LOBSTER-Robotics/EE-Dev-BAP/DCD/DCD.kicad_sch

## KiCad design DCD/DCD.kicad_sch (2026-06-09)

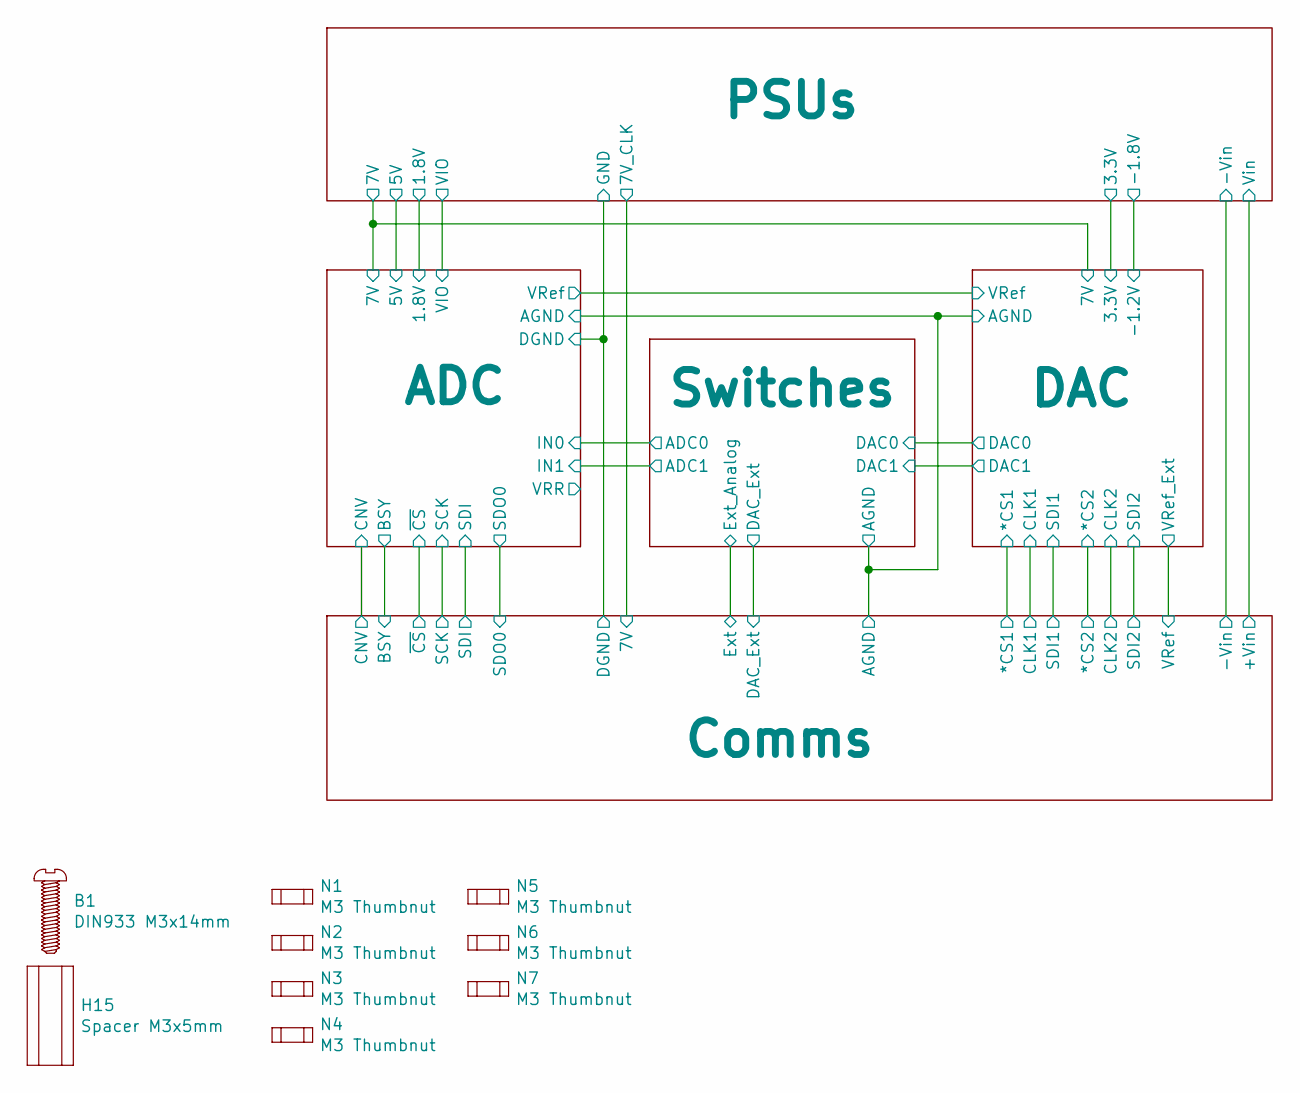
[picture p1: schematic DCD.kicad_sch]

Parts:
B1: DIN933 M3x14mm; Screw_DIN933_M3x14mm; Part number ISO7380 M5x0.8mm A2
H15: Spacer M3x5mm; ThreadedSpacer_6mm_M3x0.5_5mm; Part number M1302-3005-SS
N1, N2, N3, N4, N5, N6, N7: M3 Thumbnut; ThumbNut-M3; Part number M3561-B-12
