LOBSTER-Robotics/EE-Dev-BAP/DCD/Subcircuits/adc.kicad_sch

## KiCad design DCD/Subcircuits/adc.kicad_sch (2026-06-09)

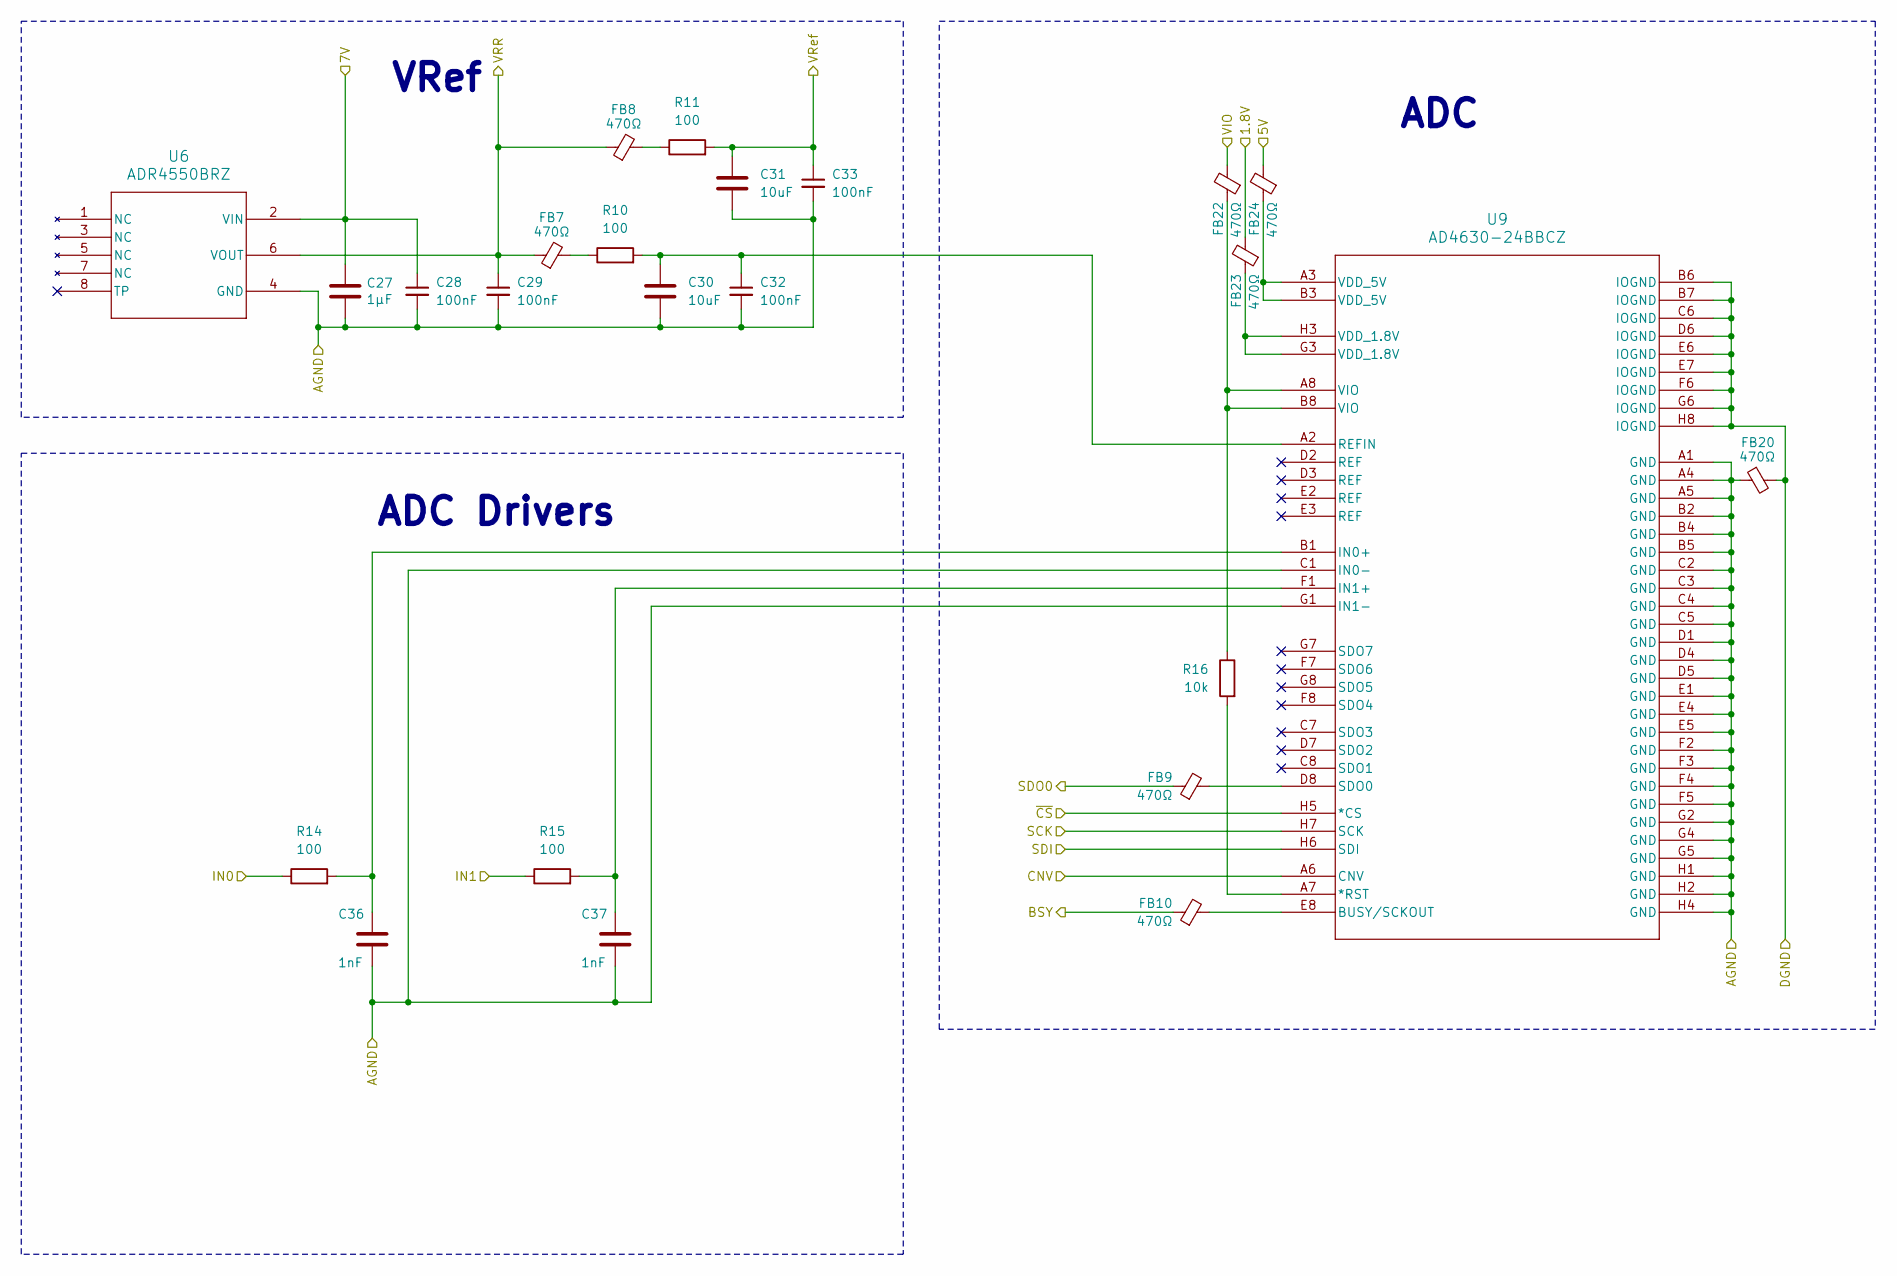
[picture p2: schematic adc.kicad_sch]

Parts:
C27: 1µF; C_0603_1608Metric; Part number GCJ188R71E105KA01D
C28, C29, C32, C33: 100nF; C_0603_1608Metric; Part number GCJ188R72A104KA1D
C30, C31: 10uF; C_1210_3225Metric; Part number GRM32EC72A106ME05L
C36, C37: 1nF; C_0603_1608Metric; Part number GCM1885C2A102FA16D
FB7, FB8, FB9, FB10, FB20, FB22, FB23, FB24: 470Ω; L_0603_1608Metric; Part number BLM18GG471SN1D
R10, R11, R15: 100; R_0603_1608Metric
R14: 100; R_0603_1608Metric; Part number ERA-3VEB1000V
R16: 10k; R_0603_1608Metric; Part number ERJ-3EKF1002V
U6: ADR4550BRZ; R_8_ADI; Part number ADR4550BRZ-R7
U9: AD4630-24BBCZ; 05-08-1797_ADI; Part number AD4630-24BBCZ

Connections:
1.8V: FB23.2
5V: FB24.2
7V: C27.1, C28.1, U6.2 (VIN)
AGND: C27.2, C28.2, C29.2, C30.2, C31.2, C32.2, C33.2, C36.2, C37.2, FB20.1, U6.4 (GND), U9.A1 (GND), U9.A4 (GND), U9.A5 (GND), U9.B2 (GND), U9.B4 (GND), U9.B5 (GND), U9.C1 (IN0-), U9.C2 (GND), U9.C3 (GND), U9.C4 (GND), U9.C5 (GND), U9.D1 (GND), U9.D4 (GND), U9.D5 (GND), U9.E1 (GND), U9.E4 (GND), U9.E5 (GND), U9.F2 (GND), U9.F3 (GND), U9.F4 (GND), U9.F5 (GND), U9.G1 (IN1-), U9.G2 (GND), U9.G4 (GND), U9.G5 (GND), U9.H1 (GND), U9.H2 (GND), U9.H4 (GND)
BSY: FB10.1
CNV: U9.A6 (CNV)
DGND: FB20.2, U9.B6 (IOGND), U9.B7 (IOGND), U9.C6 (IOGND), U9.D6 (IOGND), U9.E6 (IOGND), U9.E7 (IOGND), U9.F6 (IOGND), U9.G6 (IOGND), U9.H8 (IOGND)
IN0: R14.1
IN1: R15.1
unnamed: C30.1, C32.1, R10.2, U9.A2 (REFIN)
unnamed: C36.1, R14.2, U9.B1 (IN0+)
unnamed: C37.1, R15.2, U9.F1 (IN1+)
unnamed: FB7.2, R10.1
unnamed: FB8.2, R11.1
unnamed: FB9.2, U9.D8 (SDO0)
unnamed: FB10.2, U9.E8 (BUSY/SCKOUT)
unnamed: FB22.1, R16.1, U9.A8 (VIO), U9.B8 (VIO)
unnamed: FB23.1, U9.G3 (VDD_1.8V), U9.H3 (VDD_1.8V)
unnamed: FB24.1, U9.A3 (VDD_5V), U9.B3 (VDD_5V)
unnamed: R16.2, U9.A7 (*RST)
SCK: U9.H7 (SCK)
SDI: U9.H6 (SDI)
SDO0: FB9.1
VIO: FB22.2
VRR: C29.1, FB7.1, FB8.1, U6.6 (VOUT)
VRef: C31.1, C33.1, R11.2
~CS: U9.H5 (*CS)

Notes on the sheet:
ADC
ADC Drivers
VRef
