LOBSTER-Robotics/EE-Dev-BAP/DCD/Subcircuits/comms.kicad_sch

## KiCad design DCD/Subcircuits/comms.kicad_sch (2026-05-26)

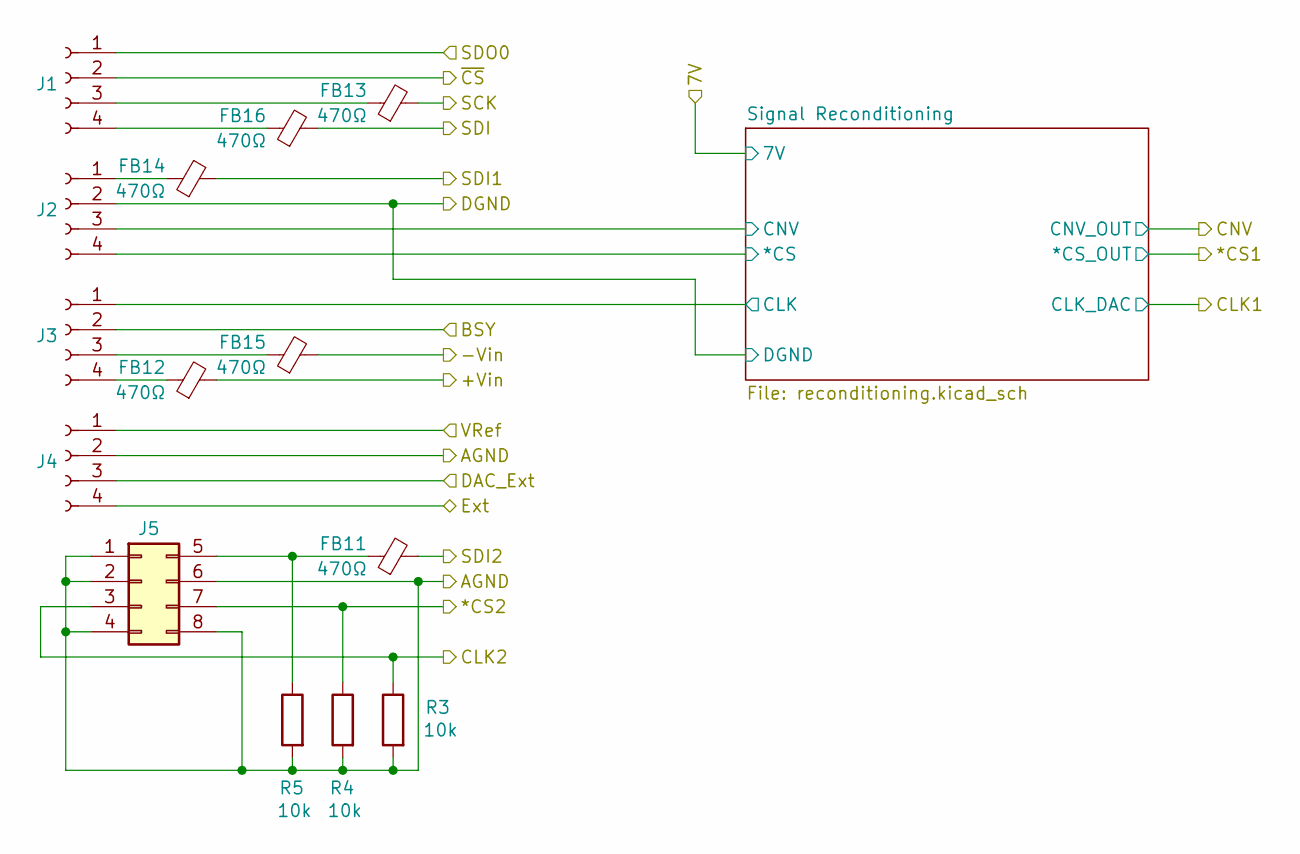
[picture p3: schematic comms.kicad_sch]

Parts:
FB11, FB12, FB13, FB14, FB15, FB16: 470Ω; L_0603_1608Metric; Part number BLM18GG471SN1D
J1, J2, J3, J4: UMPS-04-03.5-G-VT-SM-WT; Part number UMPS-04-03.5-G-VT-SM-WT-K
J5: Conn_02x04_Top_Bottom; PinHeader_2x04_P2.54mm_Vertical; Part number 90131-0763
R3, R4, R5: 10k; R_0603_1608Metric; Part number ERJ-3EKF1002V

Connections:
*CS: J2.4
+Vin: FB12.2
-Vin: FB15.2
AGND: J4.2, J5.1, J5.2, J5.4, J5.6, J5.8, R3.2, R4.2, R5.2
BSY: J3.2
CLK: J3.1
CLK2: J5.3, R3.1
CNV: J2.3
DAC_Ext: J4.3
DGND: J2.2
Ext: J4.4
unnamed: FB11.1, J5.5, R5.1
unnamed: FB12.1, J3.4
unnamed: FB13.1, J1.3
unnamed: FB14.1, J2.1
unnamed: FB15.1, J3.3
unnamed: FB16.1, J1.4
SCK: FB13.2
SDI: FB16.2
SDI1: FB14.2
SDI2: FB11.2
SDO0: J1.1
VRef: J4.1
cs2: J5.7, R4.1
~CS: J1.2
