LOBSTER-Robotics/EE-Dev-BAP/DCD/Subcircuits/dac.kicad_sch

## KiCad design DCD/Subcircuits/dac.kicad_sch (2026-05-26)

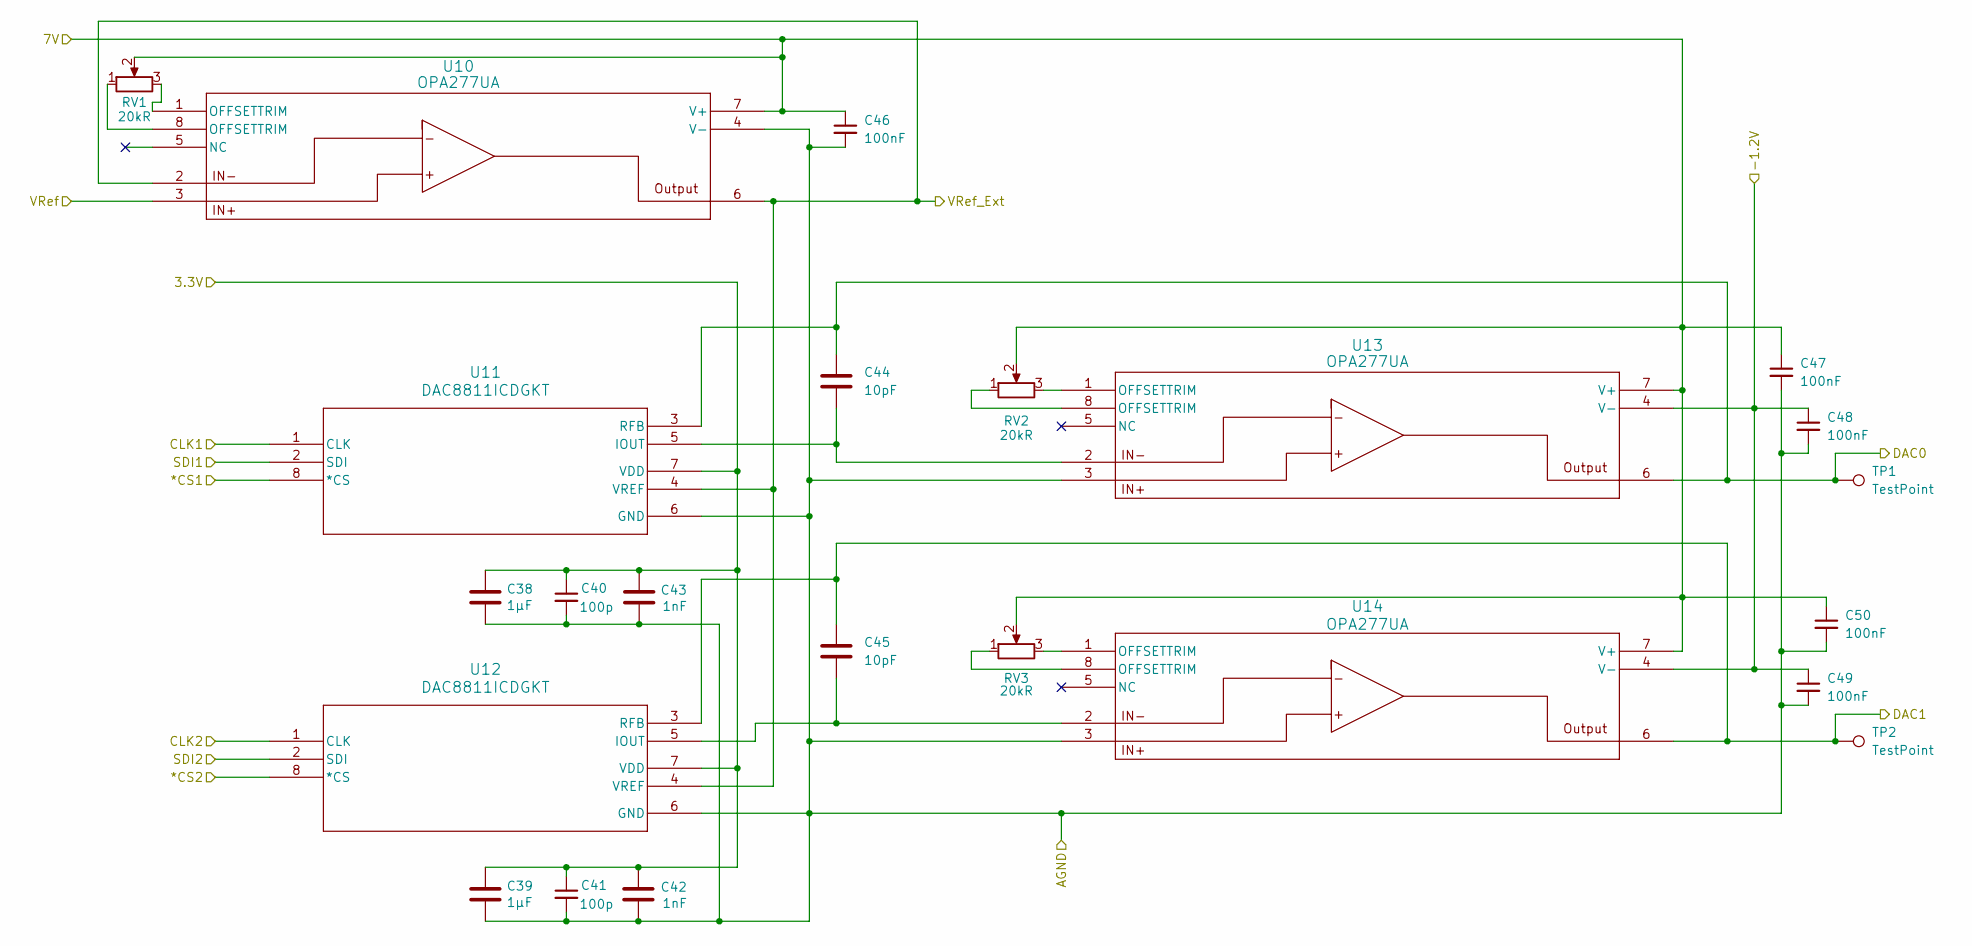
[picture p4: schematic dac.kicad_sch]

Parts:
C38, C39: 1µF; C_0603_1608Metric; Part number GCJ188R71E105KA01D
C40, C41: 100p; C_0603_1608Metric; Part number GCM1885C2A101FA16J
C42, C43: 1nF; C_0603_1608Metric; Part number GCM1885C2A102FA16D
C44, C45: 10pF; C_0603_1608Metric; Part Number GRM1885C1H9R1WA01D
C46, C47, C48, C49, C50: 100nF; C_0603_1608Metric; Part number GCJ188R72A104KA1D
RV1, RV2, RV3: 20kR; IC3_3214W-1-203E_BRN; Part number 3214W-1-203E
TP1, TP2: TestPoint; TestPoint_Pad_D1.5mm
U10, U13, U14: OPA277UA; D8; Part number OPA277UA
U11, U12: DAC8811ICDGKT; DGK8; Part number DAC8811ICDGKT

Connections:
3.3V: C38.1, C39.1, C40.1, C41.1, C42.1, C43.1, U11.7 (VDD), U12.7 (VDD)
7V: C46.1, C47.1, C50.1, RV1.2, RV2.2, RV3.2, U10.7 (V+), U13.7 (V+), U14.7 (V+)
-1.2V: C48.1, C49.1, U13.4 (V-), U14.4 (V-)
AGND: C38.2, C39.2, C40.2, C41.2, C42.2, C43.2, C46.2, C47.2, C48.2, C49.2, C50.2, U10.4 (V-), U11.6 (GND), U12.6 (GND), U13.3, U14.3
CLK1: U11.1 (CLK)
CLK2: U12.1 (CLK)
DAC0: C44.1, TP1.1, U11.3 (RFB), U13.6
DAC1: C45.1, TP2.1, U12.3 (RFB), U14.6
unnamed: C44.2, U11.5 (IOUT), U13.2
unnamed: C45.2, U12.5 (IOUT), U14.2
unnamed: RV1.1, U10.8 (OFFSETTRIM)
unnamed: RV1.3, U10.1 (OFFSETTRIM)
unnamed: RV2.1, U13.8 (OFFSETTRIM)
unnamed: RV2.3, U13.1 (OFFSETTRIM)
unnamed: RV3.1, U14.8 (OFFSETTRIM)
unnamed: RV3.3, U14.1 (OFFSETTRIM)
SDI1: U11.2 (SDI)
SDI2: U12.2 (SDI)
VRef: U10.3
VRef_Ext: U10.2, U10.6, U11.4 (VREF), U12.4 (VREF)
cs1: U11.8 (*CS)
cs2: U12.8 (*CS)
