LOBSTER-Robotics/EE-Dev-BAP/DCD/Subcircuits/psus.kicad_sch

## KiCad design DCD/Subcircuits/psus.kicad_sch (2026-06-09)

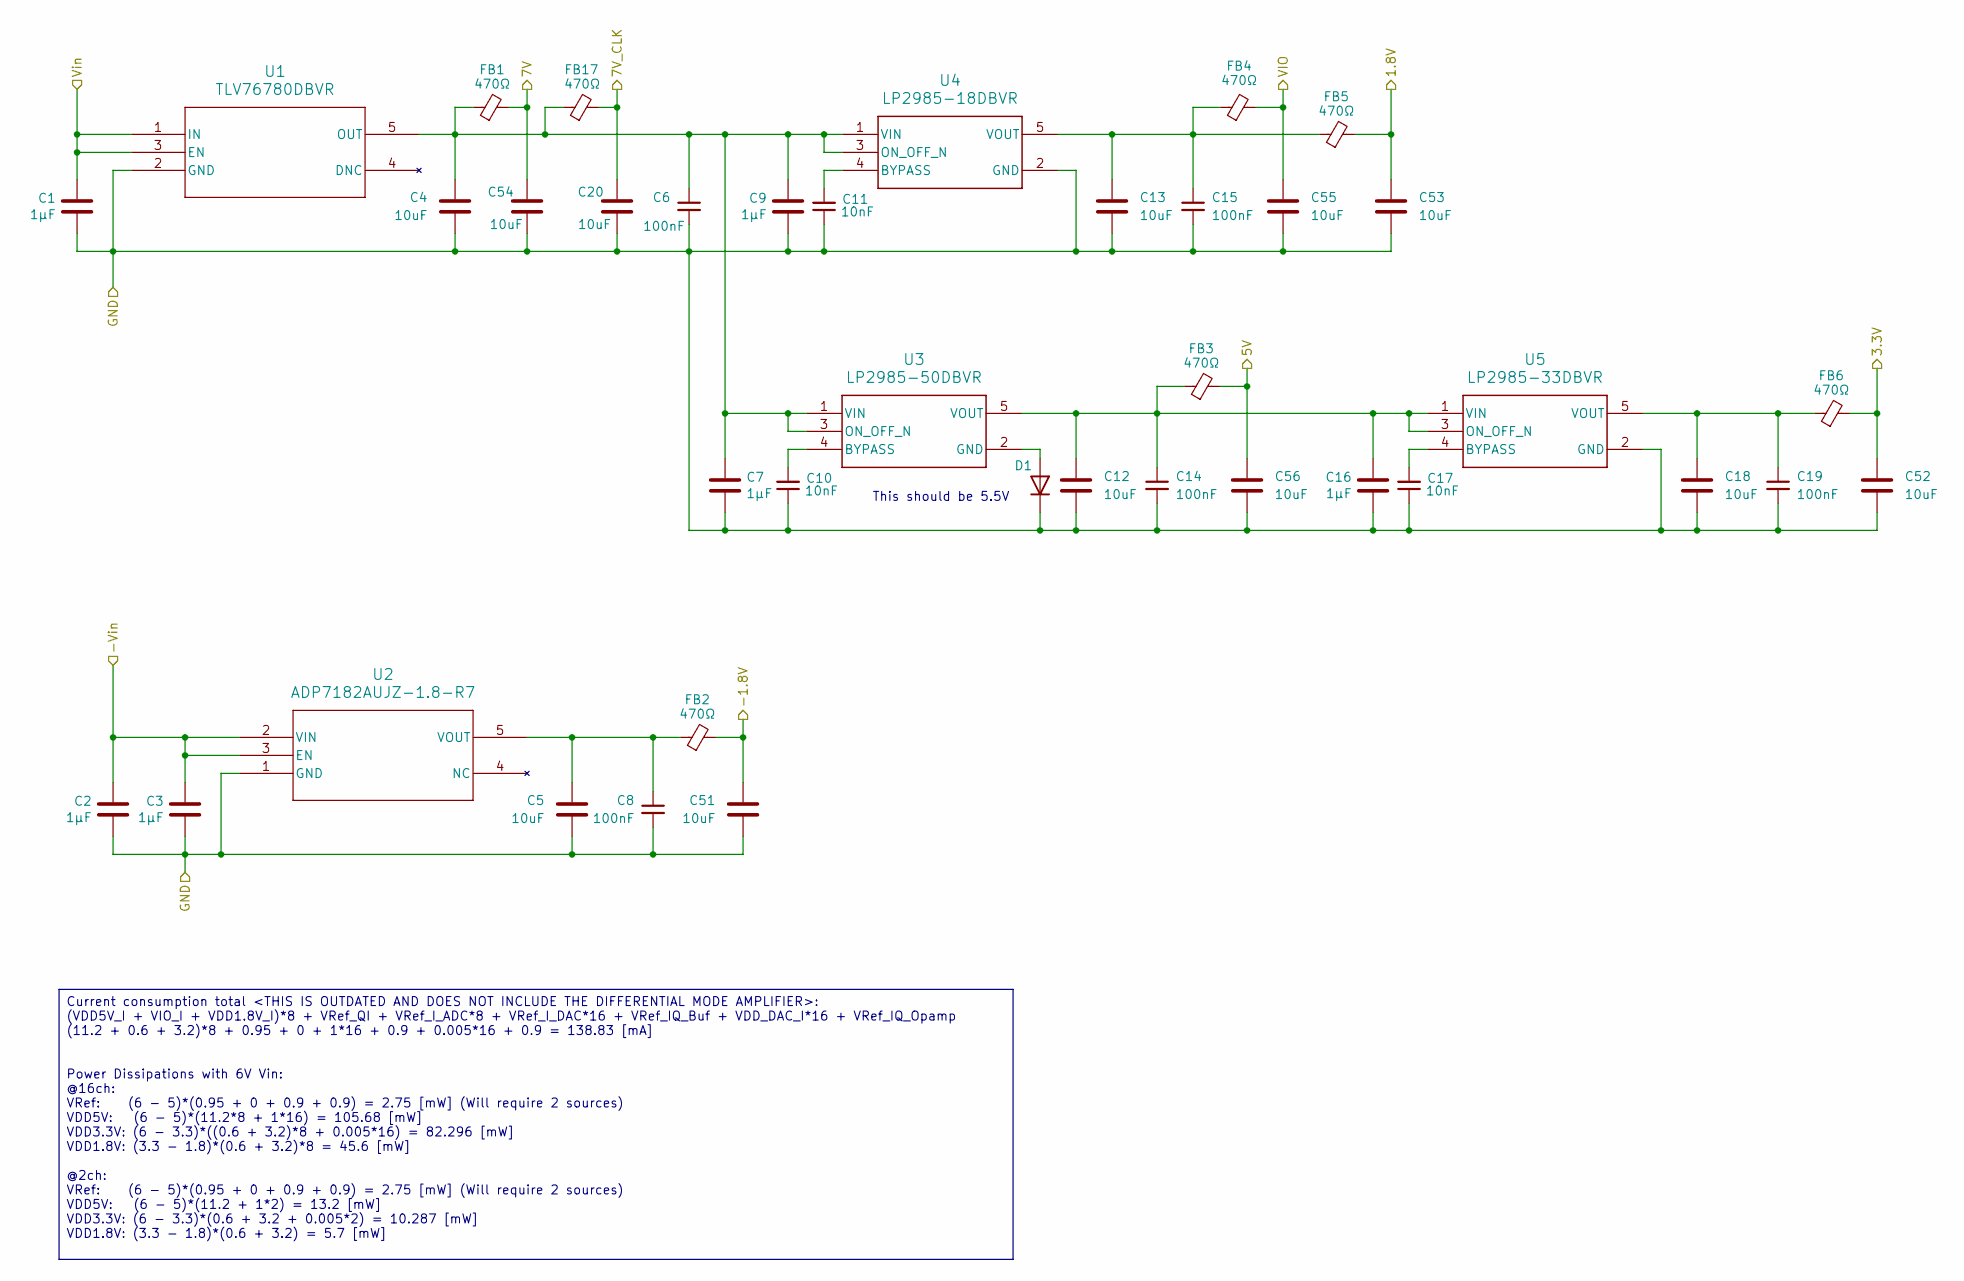
[picture p5: schematic psus.kicad_sch]

Parts:
C1, C2, C3, C7, C9, C16: 1µF; C_0603_1608Metric; Part number GCJ188R71E105KA01D
C4, C5, C12, C13, C18, C20, C51, C52, C53, C54, C55, C56: 10uF; C_1210_3225Metric; Part number GRM32EC72A106ME05L
C6, C8, C14, C15, C19: 100nF; C_0603_1608Metric; Part number GCJ188R72A104KA1D
C10, C11, C17: 10nF; C_0603_1608Metric; Part number GRM1885C1H103JA01D
D1: 1N4148WT; D_SOD-523
FB1, FB2, FB3, FB4, FB5, FB6, FB17: 470Ω; L_0603_1608Metric; Part number BLM18GG471SN1D
U1: TLV76780DBVR; SOT_80DBVR_TEX; Part number TLV76780DBVR
U2: ADP7182AUJZ-1.8-R7; UJ-5_ADI; Part number ADP7182AUJZ-1.8-R7
U3: LP2985-50DBVR; DBV0005A_N; Part number LP2985-50DBVTM3
U4: LP2985-18DBVR; DBV0005A_N; Part number LP2985-18DBVRM3
U5: LP2985-33DBVR; DBV0005A_N; Part number LP2985-33DBVRM3

Connections:
1.8V: C53.1, FB5.2
3.3V: C52.1, FB6.2
5V: C56.1, FB3.2
7V: C54.1, FB1.2
7V_CLK: C20.1, FB17.2
-1.8V: C51.1, FB2.2
-Vin: C2.1, C3.1, U2.2 (VIN), U2.3 (EN)
GND: C1.2, C2.2, C3.2, C4.2, C5.2, C6.2, C7.2, C8.2, C9.2, C10.1, C11.1, C12.2, C13.2, C14.2, C15.2, C16.2, C17.1, C18.2, C19.2, C20.2, C51.2, C52.2, C53.2, C54.2, C55.2, C56.2, D1.1 (K), U1.2 (GND), U2.1 (GND), U4.2 (GND), U5.2 (GND)
unnamed: C4.1, C6.1, C7.1, C9.1, FB1.1, FB17.1, U1.5 (OUT), U3.1 (VIN), U3.3 (ON_OFF_N), U4.1 (VIN), U4.3 (ON_OFF_N)
unnamed: C5.1, C8.1, FB2.1, U2.5 (VOUT)
unnamed: C10.2, U3.4 (BYPASS)
unnamed: C11.2, U4.4 (BYPASS)
unnamed: C12.1, C14.1, C16.1, FB3.1, U3.5 (VOUT), U5.1 (VIN), U5.3 (ON_OFF_N)
unnamed: C13.1, C15.1, FB4.1, FB5.1, U4.5 (VOUT)
unnamed: C17.2, U5.4 (BYPASS)
unnamed: C18.1, C19.1, FB6.1, U5.5 (VOUT)
unnamed: D1.2 (A), U3.2 (GND)
VIO: C55.1, FB4.2
Vin: C1.1, U1.1 (IN), U1.3 (EN)

Notes on the sheet:
This should be 5.5V
Current consumption total <THIS IS OUTDATED AND DOES NOT INCLUDE THE DIFFERENTIAL MODE AMPLIFIER>: (VDD5V_I + VIO_I + VDD1.8V_I)*8 + VRef_QI + VRef_I_ADC*8 + VRef_I_DAC*16 + VRef_IQ_Buf + VDD_DAC_I*16 + VRef_IQ_Opamp (11.2 + 0.6 + 3.2)*8 + 0.95 + 0 + 1*16 + 0.9 + 0.005*16 + 0.9 = 138.83 [mA] Power 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
