LOBSTER-Robotics/EE-Dev-BAP/DCD/Subcircuits/reconditioning.kicad_sch

## KiCad design DCD/Subcircuits/reconditioning.kicad_sch (2026-06-11)

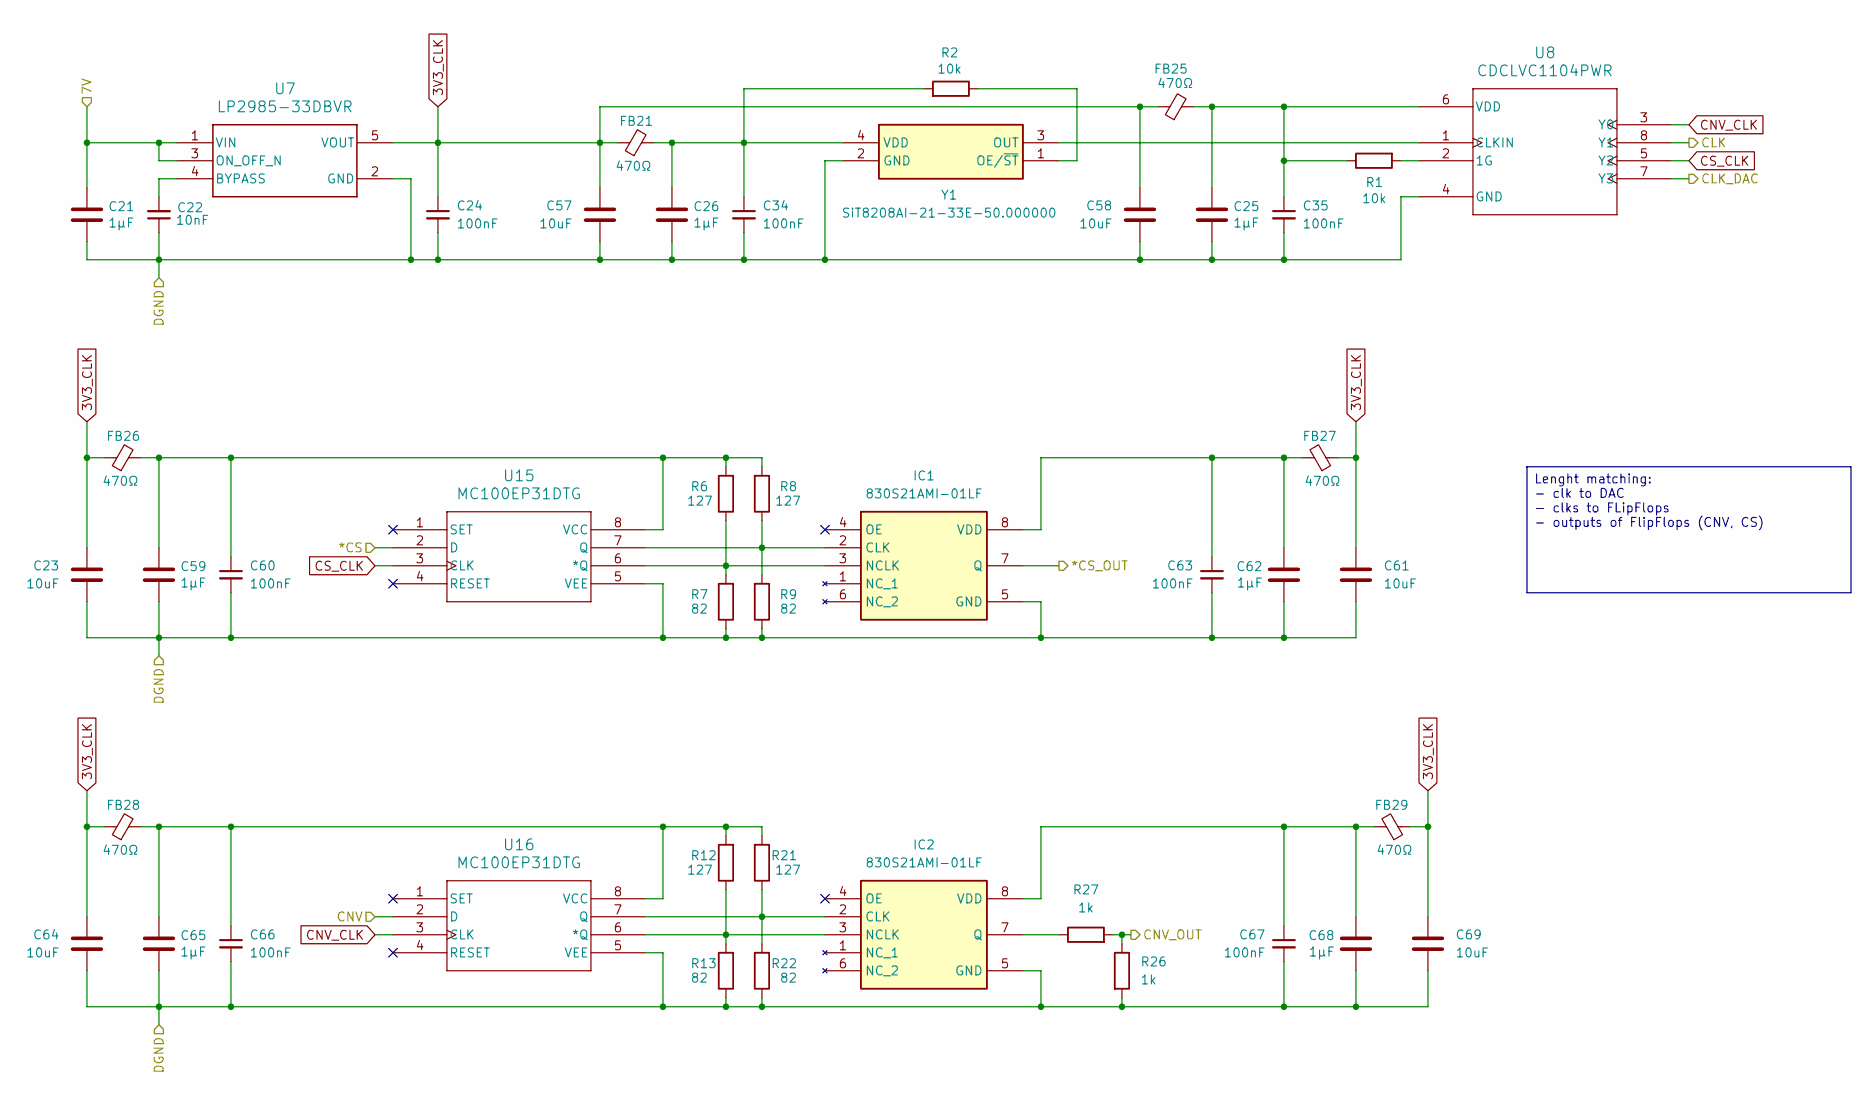
[picture p6: schematic reconditioning.kicad_sch]

Parts:
C21, C25, C26, C59, C62, C65, C68: 1µF; C_0603_1608Metric; Part number GCJ188R71E105KA01D
C22: 10nF; C_0603_1608Metric; Part number GRM1885C1H103JA01D
C23, C57, C58, C61, C64, C69: 10uF; C_1210_3225Metric; Part number GRM32EC72A106ME05L
C24, C34, C35, C60, C63, C66, C67: 100nF; C_0603_1608Metric; Part number GCJ188R72A104KA1D
FB21, FB25, FB26, FB27, FB28, FB29: 470Ω; L_0603_1608Metric; Part number BLM18GG471SN1D
IC1, IC2: 830S21AMI-01LF; SOIC127P600X175-8N; Part number 830S21AMI-01LF
R1, R2: 10k; R_0603_1608Metric; Part number ERJ-3EKF1002V
R6, R8, R12, R21: 127; R_0603_1608Metric; Part number ERA-3AEB1270V
R7, R9, R13, R22: 82; R_0603_1608Metric; Part number ERA-3AEB820V
R26, R27: 1k
U7: LP2985-33DBVR; DBV0005A_N; Part number LP2985-33DBVRM3
U8: CDCLVC1104PWR; PW8; Part number CDCLVC1104PWR
U15, U16: MC100EP31DTG; TSSOP8_3P10X3P10_ONS; Part number MC100EP31DTG
Y1: SiT8208AI-21-33E-50.000000; QFN_3225_4pins; Manufacturer_Part_Number SiT8208AI-21-33E-50.000000

Connections:
3V3_CLK: C23.1, C24.1, C57.1, C58.1, C61.1, C64.1, C69.1, FB21.1, FB25.1, FB26.1, FB27.1, FB28.1, FB29.1, U7.5 (VOUT)
7V: C21.1, U7.1 (VIN), U7.3 (ON_OFF_N)
CLK: U8.8 (Y1)
CLK_DAC: U8.7 (Y3)
CNV: U16.2 (D)
CNV_CLK: U8.3 (Y0), U16.3 (CLK)
CNV_OUT: R26.1, R27.2
CS_CLK: U8.5 (Y2), U15.3 (CLK)
DGND: C21.2, C22.1, C23.2, C24.2, C25.2, C26.2, C34.2, C35.2, C57.2, C58.2, C59.2, C60.2, C61.2, C62.2, C63.2, C64.2, C65.2, C66.2, C67.2, C68.2, C69.2, IC1.5 (GND), IC2.5 (GND), R7.1, R9.1, R13.1, R22.1, R26.2, U7.2 (GND), U8.4 (GND), U15.5 (VEE), U16.5 (VEE), Y1.2 (GND)
unnamed: C22.2, U7.4 (BYPASS)
unnamed: C25.1, C35.1, FB25.2, R1.1, U8.6 (VDD)
unnamed: C26.1, C34.1, FB21.2, R2.2, Y1.4 (VDD)
unnamed: C59.1, C60.1, FB26.2, R6.2, R8.2, U15.8 (VCC)
unnamed: C62.1, C63.1, FB27.2, IC1.8 (VDD)
unnamed: C65.1, C66.1, FB28.2, R12.2, R21.2, U16.8 (VCC)
unnamed: C67.1, C68.1, FB29.2, IC2.8 (VDD)
unnamed: IC1.2 (CLK), R8.1, R9.2, U15.7 (Q)
unnamed: IC1.3 (NCLK), R6.1, R7.2, U15.6 (*Q)
unnamed: IC2.2 (CLK), R21.1, R22.2, U16.7 (Q)
unnamed: IC2.3 (NCLK), R12.1, R13.2, U16.6 (*Q)
unnamed: IC2.7 (Q), R27.1
unnamed: R1.2, U8.2 (1G)
unnamed: R2.1, Y1.1 (OE/~ST)
unnamed: U8.1 (CLKIN), Y1.3 (OUT)
cs: U15.2 (D)
cs_out: IC1.7 (Q)

Notes on the sheet:
Lenght matching: - clk to DAC - clks to FLipFlops - outputs of FlipFlops (CNV, CS)
