LOBSTER-Robotics/EE-Dev-BAP/DCD/Subcircuits/switches.kicad_sch

## KiCad design DCD/Subcircuits/switches.kicad_sch (2026-06-09)

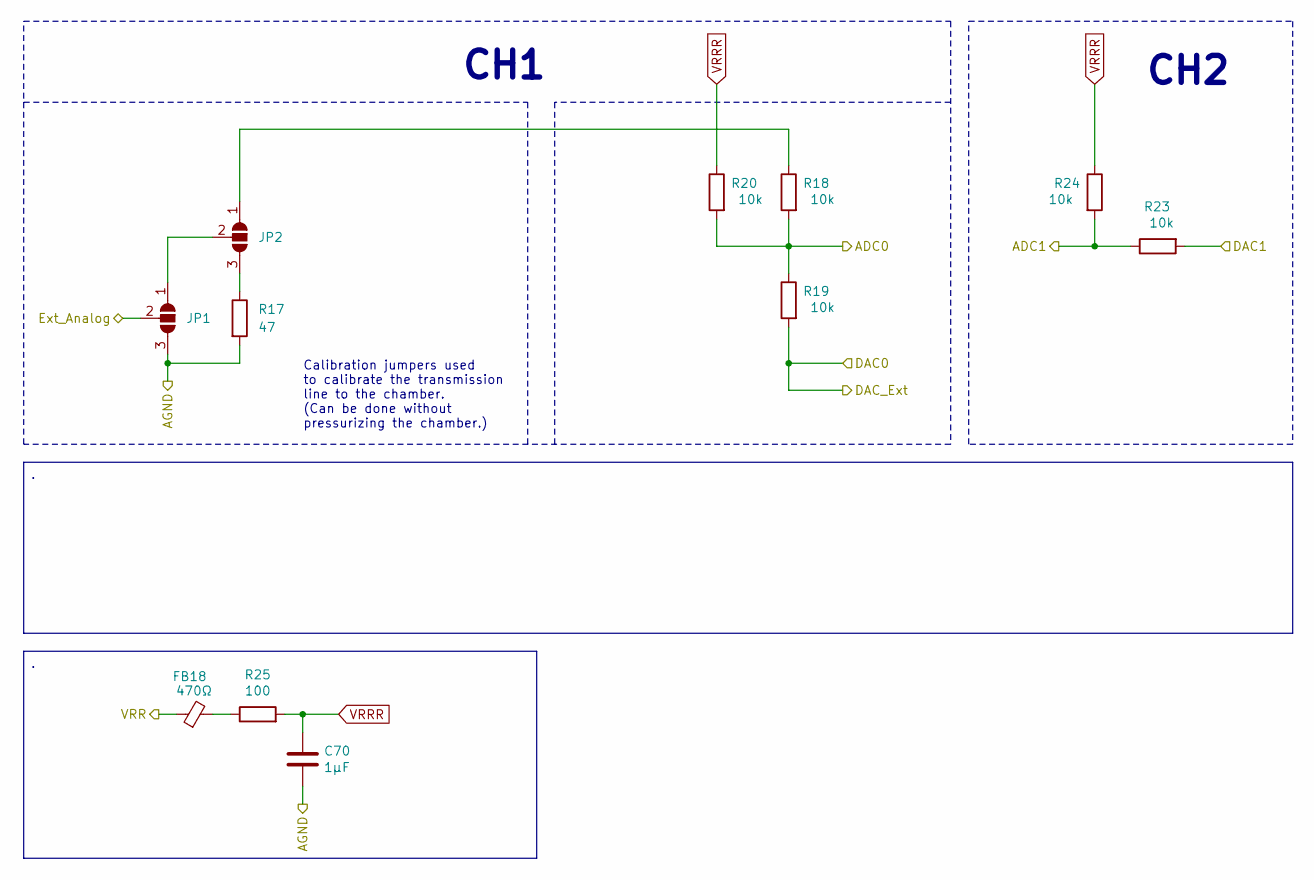
[picture p7: schematic switches.kicad_sch]

Parts:
C70: 1µF; C_0603_1608Metric; Part number GCJ188R71E105KA01D
FB18: 470Ω; L_0603_1608Metric; Part number BLM18GG471SN1D
JP1, JP2: SolderJumper_3_Open; SolderJumper-3_P1.3mm_Open_RoundedPad1.0x1.5mm
R17: 47; R_0603_1608Metric; Part number ERA-3AEB470V
R18, R19, R20, R23, R24: 10k; R_0603_1608Metric; Part number ERJ-3EKF1002V
R25: 100; R_0603_1608Metric

Connections:
ADC0: R18.2, R19.1, R20.2
ADC1: R23.1, R24.2
AGND: C70.2, JP1.3 (B), R17.2
DAC0: R19.2
DAC1: R23.2
Ext_Analog: JP1.2 (C)
unnamed: FB18.2, R25.1
unnamed: JP1.1 (A), JP2.2 (C)
unnamed: JP2.1 (A), R18.1
unnamed: JP2.3 (B), R17.1
VRR: FB18.1
VRRR: C70.1, R20.1, R24.1, R25.2

Notes on the sheet:
CH1
Calibration jumpers used to calibrate the transmission line to the chamber. (Can be done without pressurizing the chamber.)
CH2
