LOBSTER-Robotics/EE-Dev-BAP/(commit log)

2026-04-30 Added the ADC to the libs and implemented it
    [DCD.kicad_pcb, DCD.kicad_sch, adc.kicad_sch, comms.kicad_sch, dac.kicad_sch, psus.kicad_sch, switches.kicad_sch]
2026-05-01 added DAC8811ICDGKT to library
    [dac.kicad_sch]
2026-05-01 Added the Refrence Voltage Source
2026-05-01 DAC schematic with opamp and top level added
    [DCD.kicad_sch, dac.kicad_sch]
2026-05-04 Added the Vref supply, finished all of the top level connections
    [adc.kicad_sch]
2026-05-04 Did the signal switching, finished ADC, misc changes to top
    Decided to go with solder jumpers instead of power switches bc power
    switches have no specs of linearity and they would add unnecessary
    complexity, development time, and routing problems.
    The calibration test has to be done only once and the chamber doesn't
    even have to be sealed for it, so it shouldn't add too much hassle.
    [DCD.kicad_sch, adc.kicad_sch, dac.kicad_sch, switches.kicad_sch]
2026-05-05 DAC design done and added component potentiometer
    [DCD.kicad_sch, dac.kicad_sch]
2026-05-05 Finished switches, added calculations of the current consumption
    [adc.kicad_sch, psus.kicad_sch, switches.kicad_sch]
2026-05-05 buffer added for vref to dac circuit
    [dac.kicad_sch]
2026-05-05 Added PSUS, progress on the PSU circuit design, slight tweaks to the rest
    [DCD.kicad_sch, adc.kicad_sch, psus.kicad_sch]
2026-05-05 added decoupling capacitors to dac circuit
    [dac.kicad_sch]
2026-05-06 cleaned up dac circuit a bit
    [dac.kicad_sch]
2026-05-07 Added the ADC driver IC
2026-05-07 Progress on the implementation of the DAC driver
    [DCD.kicad_sch, adc.kicad_sch, dac.kicad_sch, switches.kicad_sch]
2026-05-08 Fixed the switches, finished the adc amplifier, missing the filer to adc
    [DCD.kicad_sch, adc.kicad_sch, dac.kicad_sch, psus.kicad_sch, switches.kicad_sch]
2026-05-11 Finished the schematics. Fixed the comments that we recieved
    [DCD.kicad_pcb, DCD.kicad_sch, adc.kicad_sch, comms.kicad_sch, dac.kicad_sch, psus.kicad_sch, switches.kicad_sch]
2026-05-11 added voltage divider to dac circuits for opamps
    [dac.kicad_sch]
2026-05-11 reverted last changes made to dac
    [dac.kicad_sch]
2026-05-12 7v and -1.2V supplying opa277s
    [dac.kicad_sch]
2026-05-12 Added negative voltage LDO and 7V LDO
2026-05-12 Finished
    Final touches, PSUs filtering, external connections, psu connections for
    the negative voltage, and the DAC higher voltage, and the negative
    voltage. Added an external connection directely to the DAC.
    [DCD.kicad_pcb, DCD.kicad_sch, adc.kicad_sch, comms.kicad_sch, dac.kicad_sch, psus.kicad_sch, switches.kicad_sch]
2026-05-12 Progress on the component placement
    [DCD.kicad_pcb]
2026-05-13 Added footprints from the Lobster librariries for the breakout connections
2026-05-13 Progress on fixing the remaining footprints and 3 models
    [DCD.kicad_pcb, DCD.kicad_sch, comms.kicad_sch]
2026-05-18 Progress on the layout
    [DCD.kicad_pcb, DCD.kicad_sch, adc.kicad_sch, comms.kicad_sch, dac.kicad_sch, psus.kicad_sch, switches.kicad_sch]
2026-05-20 Added signal reconditioning components and thier footprints
2026-05-21 Schematics for the clock reconditioning
    [DCD.kicad_pcb, DCD.kicad_sch, adc.kicad_sch, comms.kicad_sch, psus.kicad_sch, reconditioning.kicad_sch]
2026-05-21 Finished the reconditioning circuit
    [reconditioning.kicad_sch]
2026-05-21 Added the components for the reconditioning to the pcb
    [DCD.kicad_pcb]
2026-05-21 Progress on the layout of the signal reconditioning circuit
    [DCD.kicad_pcb]
2026-05-21 Layout mostly done
    [DCD.kicad_pcb, DCD.kicad_sch, comms.kicad_sch, reconditioning.kicad_sch]
2026-05-21 Added the pin header
    [comms.kicad_sch]
2026-05-21 Connected the pin header in the schematics
    [DCD.kicad_sch, comms.kicad_sch]
2026-05-21 Added the footprint
    My libraries are fucked for some reason so I have to change machines to
    pull footprints and add components
    [DCD.kicad_pcb, comms.kicad_sch]
2026-05-21 Almost finished the layout. Did all of the power and top layer
    [DCD.kicad_pcb, comms.kicad_sch]
2026-05-22 Stiching ground
    [DCD.kicad_pcb]
2026-05-25 Finished the layout
    Modified ground planes separation, finished stiching, fixed drc errors
    [DCD.kicad_pcb, comms.kicad_sch, dac.kicad_sch]
2026-05-26 Added biasing and termination resistors for the logic gates
    [DCD.kicad_pcb, reconditioning.kicad_sch]
2026-05-26 Added components part numbers and stuff. Added termination resistors
    [DCD.kicad_pcb, adc.kicad_sch, comms.kicad_sch, switches.kicad_sch]
2026-05-26 added part numbers
    [dac.kicad_sch]
2026-05-26 Changed the supplier of the ADC to mouser
    [adc.kicad_sch]
2026-06-09 Added bodges
    [DCD.kicad_sch, adc.kicad_sch, psus.kicad_sch, switches.kicad_sch]
2026-06-11 Reduced the output voltage of the CNV reconditioned signal for the ADC
    [reconditioning.kicad_sch]
2026-09-10 Component placement
    [DCD.kicad_pcb]
