LOBSTER-Robotics/EE-Dev-BAP/(notices)

Notices in the files:
parts and their libraries:
https://nl.mouser.com/ProductDetail/Bourns/3214W-1-203E?qs=GbiU%252BivmtKB3XfZ2%2Ff5lhA%3D%3D&srsltid=AfmBOorPnhTP9qioLG8BpPUi_eeq2XRW0Tmho28Ta1j7-AgpL_R3vvCr
